velentr/EE90/src/pwm.c

/*
 * pwm.c
 *
 * Open and close the dog bowl with PWM.
 *
 * This file contains functions for using the PWM module for opening and closing
 * the dog bowl. The PWM port is connected to a servo motor, so changing the PWM
 * to a specific duty cycle will move the servo to the corresponding position.
 *
 * Peripherals Used:
 *      PWM
 *
 * Pins Used:
 *      PB7
 *
 * Revision History:
 *      05 Jun 2015     Brian Kubisiak      Initial revision.
 */

#include <avr/io.h>

#include "pwm.h"

#define BOWL_OPEN   30
#define BOWL_CLOSED 15

/*
 * init_pwm
 *
 * Description: Initializes the PWM controlling the servo motor for
 *              opening/closing the dog bowl. This will set up the PWM pin for
 *              use and initialize the servo to a closed position.
 *
 * Notes:       The PWM uses the pin PB7; using this pin somewhere else could
 *              cause problems.
 */
void init_pwm(void)
{
    DDRB = 0x80;    /* Enable output on the PWM pin. */
    TCCR0A = 0x83;  /* Set pin to fast PWM mode. */
    TCCR0B = 0x05;  /* Prescale clock by 1024. */

    /* Start out with the bowl closed. */
    pwm_close();
}

/*
 * pwm_open
 *
 * Description: Open the dog bowl by moving the servo to a set open position.
 *              The servo is controlled by changing the duty cycle on the PWM
 *              output.
 *
 * Notes:       This function can be called multiple times in a row with no
 *              effect.
 */
void pwm_open(void)
{
    /* Set the new PWM compare value. */
    OCR0A = BOWL_OPEN;
}

/*
 * pwm_close
 *
 * Description: Close the dog bowl by moving the servo to a set closed position.
 *              The servo is controlled by changing the duty cycle on the PWM
 *              output.
 *
 * Notes:       This function can be called multiple times in a row with no
 *              effect.
 */
void pwm_close(void)
{
    /* Set the new PWM compare value. */
    OCR0A = BOWL_CLOSED;
}
