velentr/EE90/(commit log)

2015-04-10 Initial commit.
    Proposal written, design for the microphone amplifier is completed, and parts
    have been ordered. Datasheets for my parts are included in the repo.
    [microphone.sch]
2015-04-11 Draw schematic for range finders.
    [rangefinders.sch]
2015-04-15 Add rectifier to microphone amplifier.
    Neglected to amplify the microphone output before amplifying it. Now, the out is
    guarenteed to be within 0-5V for the ADC. Note that the rectified signal will
    have a different FFT, but it will still be unique, so this won't matter.
    [microphone.sch]
2015-04-17 Add load resistor to microphone circuit.
    The AC coupling capacitor is charging up without a resistive load to discharge.
    Added a 100 kOhm resistor to prevent charge from accumulating. Also, renamed
    directories to shorter names.
    [microphone.sch, rangefinders.sch]
2015-04-25 Draw final schematic for audio amp.
    The final design for the audio amplifier and triggering logic is done. The
    project documentation for this part has been written.
    [microphone.sch]
2015-04-28 Add source code, update functional specification.
    Source code is still WIP, but the basic outline of the FFT is in place. The
    functional specification has been updated for the midterm.
    [rangefinders.sch]
2015-05-26 Rangefinders tested, R6 and R7 given values.
    All the analog circuitry has been tested. Documentation updated slightly to fix
    the issue with omegas. XeLaTeX no longer required for compilation with the new
    'sourceserifpro' package.
2015-06-05 Finished FFT, with python script to generate roots of unity.
    Full testbench not yet written, so the FFT may not be entirely correct.
    [fft.c, genroots.py]
2015-06-05 Add testbench for FFT.
    Simple testbench written for FFT. FFT is debugged and works for the test input.
    No overflows/underflows found, but the test won't catch everything. Makefile
    written for managing the build.
    [data.h, fft.c, genroots.py, test-fft.c]
2015-06-06 Add proximity sensor code.
    Added code for initializing/reading data from the proximity sensors. Updated the
    build system to compile for AVR platform.
2015-06-06 Update functional specification.
    Functional specification has been updated with the newest code and latest
    schematics. A couple of minor errors were corrected.
2015-06-06 Add functions for analog data collection.
    Functions for collecting data from the ADC are added. Small modifications to
    existing hardware interface code to use builtin libraries. Documentation and
    build files updated.
2015-06-06 Design finite state machine for main loop.
    Documentation updated with the design of the finite state machine for
    controlling the dog bowl. Slight modification to the ADC code to make resets
    easier.
    [adc.c]
2015-06-07 Add PWM servo control, external trigger for data collection.
    Servo control using the PWM peripheral has been added. Externally-triggered
    interrupt has been added for starting the data collection. Documentation and
    build systems updated.
2015-06-09 Write main loop, FFT analysis.
    Mainloop is complete. FFT analysis code is written, with the ROMed key value
    blank. Minor bug fixed in the interrupt code for the ADC.
    [adc.c, fft.c, fft.h, key.c, mainloop.c]
2015-06-09 Final tweaks to code.
    Fixed all the constants, got the correct key.
    [fft.c, key.c, mainloop.c, pwm.c]
